rummanwaqar/speedy_bldc/README.md

# Speedy - The Badass Brushless Motor Controller
