rummanwaqar/speedy_bldc/hardware/sch.png

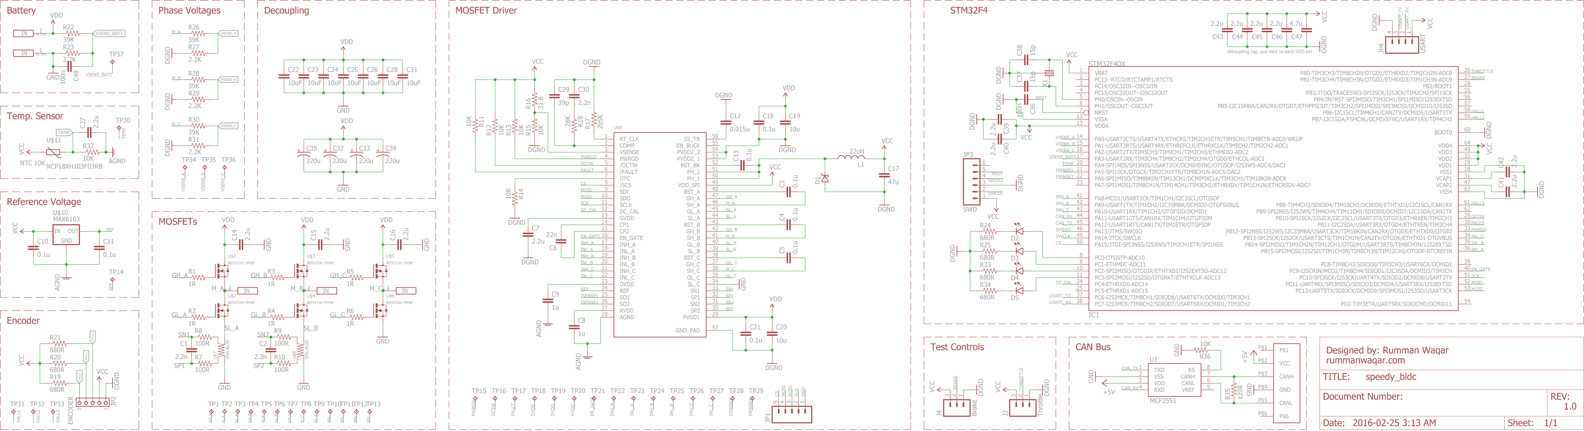
hardware/sch.png
