rummanwaqar/speedy_bldc/hardware/speedy_bldc.sch

## EAGLE design hardware/speedy_bldc.sch (2016-03-04)

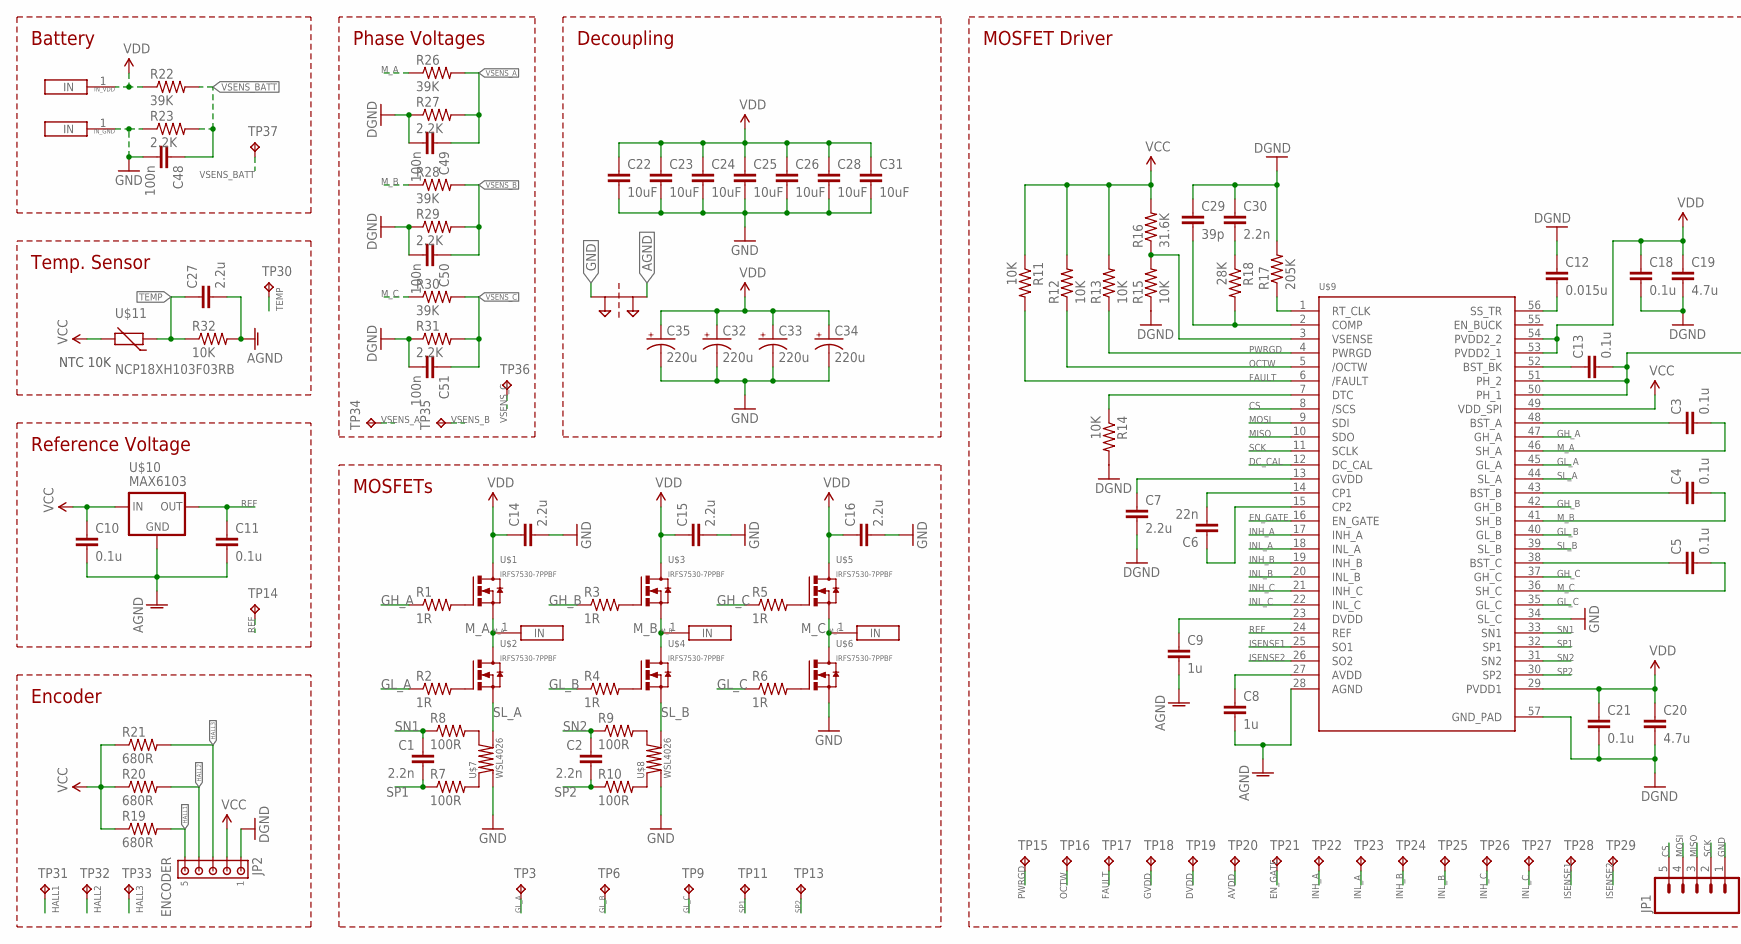
[picture p3: schematic speedy_bldc.sch, part in row 1, column 1]

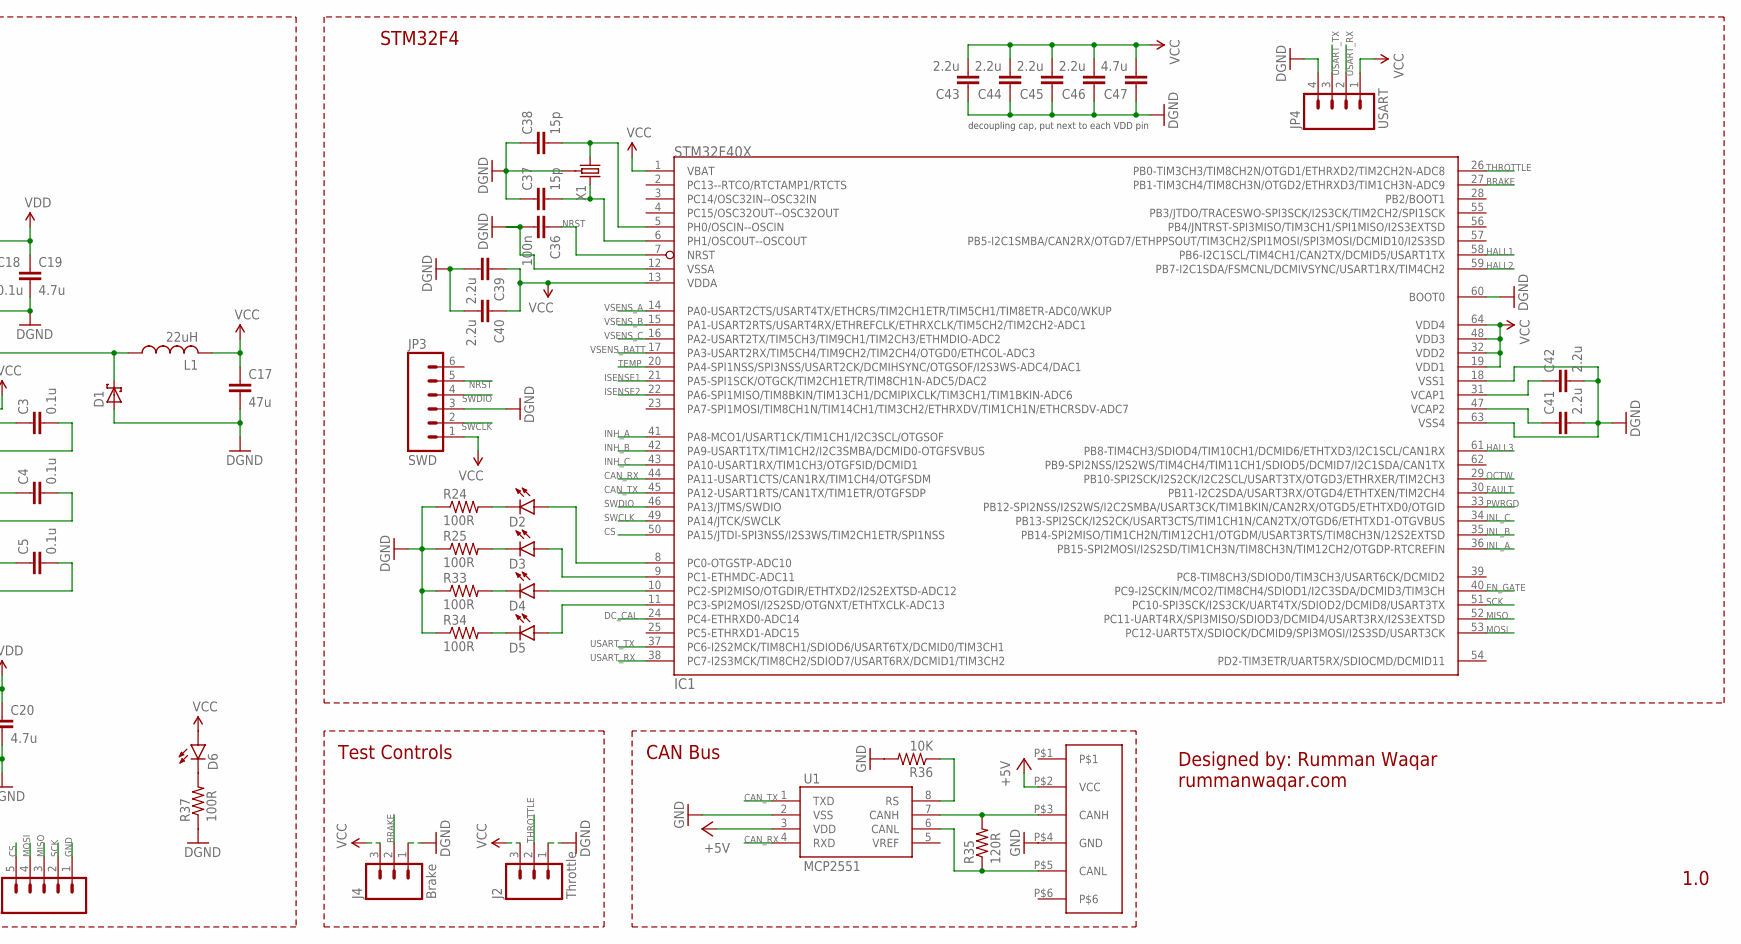
[picture p4: schematic speedy_bldc.sch, part in row 1, column 2]

Parts:
C1, C2, C30: 2.2n; 0603-CAP; PARTNO 399-7880-1-ND
C3, C4, C5: 0.1u; 0603-CAP; VOLTAGE 16V; PARTNO 399-7845-1-ND
C6: 22n; 0603-CAP; VOLTAGE 60V; PARTNO 1276-1936-1-ND
C7: 2.2u; 0603-CAP; VOLTAGE 16V; PARTNO 1276-1879-1-ND
C8: 1u; 0603-CAP; VOLTAGE 10V; PARTNO 587-2984-1-ND
C9: 1u; 0603-CAP; VOLTAGE 6.3V; PARTNO 587-2984-1-ND
C10, C11, C13, C18, C21: 0.1u; 0603-CAP; PARTNO 399-7845-1-ND
C12: 0.015u; 0603-CAP; PARTNO 587-1097-1-ND
C14, C15, C16: 2.2u; 1206-CAP; PARTNO 445-5208-1-ND
C17: 47u; 1206; PARTNO 490-3907-1-ND
C19, C20: 4.7u; 0805; PARTNO 1276-1248-1-ND
C22, C23, C24, C25, C26, C28, C31: 10uF; 1206; PARTNO 587-3248-1-ND
C27, C39, C40, C41, C42, C43, C44, C45, C46: 2.2u; 0603-CAP; PARTNO 1276-1879-1-ND
C29: 39p; 0603-CAP; PARTNO 712-1345-1-ND
C32, C33, C34, C35: 220u; E3,5-8; PARTNO 493-11950-1-ND
C36, C48, C49, C50, C51: 100n; 0603-CAP; PARTNO 399-1097-1-ND
C37, C38: 15p; 0603-CAP; PARTNO 712-1318-1-ND
C47: 4.7u; 0603-CAP; PARTNO 490-3302-1-ND
D1: SCHOTTKY_SMA; SMA; PARTNO 497-12285-1-ND
D2, D3, D4, D5, D6: LED-FKIT-1206; FKIT-LED-1206; PARTNO 160-1457-1-ND
IC1: STM32F40X; LQFP64; PARTNO 497-11767-ND
IN_GND: 1CONN
IN_VDD: 1CONN
J2: Throttle; 1X03
J4: Brake; 1X03
JP1: M05NO_SILK; 1X05_NO_SILK
JP2: ENCODER; 1445055-5; PARTNO A33210-ND
JP3: SWD; 1X06_NO_SILK
JP4: USART; 1X04
L1: 22uH; L5650M; PARTNO 490-5272-1-ND
M_A: 1CONN
M_B: 1CONN
M_C: 1CONN
PT1: 2PT_GND_TIE
R1, R2, R3, R4, R5, R6: 1R; 0603-RES; PARTNO 1276-4991-1-ND
R7, R8, R9, R10, R24, R25, R33, R34, R37: 100R; 0603-RES; PARTNO 311-100HRCT-ND
R11, R12, R13, R14, R15, R36: 10K; 0603-RES; PARTNO 311-10KGRCT-ND
R16: 31.6K; 0603-RES; PARTNO 311-31.6KHRCT-ND
R17: 205K; 0603-RES; PARTNO 541-205KHCT-ND
R18: 28K; 0603-RES; PARTNO 311-28.0KHRCT-ND
R19, R20, R21: 680R; 0603-RES; PARTNO 311-680HRCT-ND
R22, R26, R28, R30: 39K; 0603-RES; PARTNO 311-39.0KHRCT-ND
R23, R27, R29, R31: 2.2K; 0603-RES; PARTNO 311-2.20KHRCT-ND
R32: 10K; 0603-RES; PARTNO RHM10.0KHCT-ND
R35: 120R; 0603-RES; PARTNO 311-120GRCT-ND
TP3, TP6, TP9, TP11, TP13, TP14, TP15, TP16, TP17, TP18, TP19, TP20, TP21, TP22, TP23, TP24, TP25, TP26, TP27, TP28, TP29, TP30, TP31, TP32, TP33, TP34, TP35, TP36, TP37: TPB1,27; B1,27
U1: MCP2551; SO08; PARTNO MCP2551T-E/SNCT-ND
U$1, U$2, U$3, U$4, U$5, U$6: IRFS7530-7PPBF; D2PAK-7PIN; PARTNO IRFS7530-7PPBF-ND
U$7, U$8: WSL4026; PARTNO WSLR-.0003CT-ND
U$9: DRV8301; 56-TSSOP-POWERPAD; PARTNO 296-29433-1-ND
U$10: MAX6103; SOT23-3; PARTNO MAX6103EUR+TCT-ND
U$11: NCP18XH103F03RB; R0603; PARTNO 490-4800-1-ND
U$12: CAN_6P6C; PARTNO 553-2258-ND
X1: X1; CRYSTAL-SMD-5X3; PARTNO 535-9721-1-ND

Connections:
+5V: U1.3 (VDD), U$12.P$2 (VCC)
AGND: C8.2, C9.2, C10.2, C11.2, C27.2, PT1.P$2, R32.2, U$9.28 (AGND), U$10.3 (GND)
AVDD: TP20.TP
BRAKE: IC1.27 (PB1-TIM3CH4/TIM8CH3N/OTGD2/ETHRXD3/TIM1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), J4.2
CAN_RX: IC1.44 (PA11-USART1CTS/CAN1RX/TIM1CH4/OTGFSDM), U1.4 (RXD)
CAN_TX: IC1.45 (PA12-USART1RTS/CAN1TX/TIM1ETR/OTGFSDP), U1.1 (TXD)
CS: IC1.50 (PA15/JTDI-SPI3NSS/I2S3WS/TIM2CH1ETR/SPI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), JP1.5, U$9.8 (/SCS)
DC_CAL: IC1.24 (PC4-ETHRXD0-ADC14), U$9.12 (DC_CAL)
DVDD: TP19.TP
EN_GATE: IC1.40 (PC9-I2SCKIN/MCO2/TIM8CH4/SDIOD1/I2C3SDA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), TP21.TP, U$9.16 (EN_GATE)
FAULT: IC1.30 (PB11-I2C2SDA/USART3RX/OTGD4/ETHTXEN/TIM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), R11.2, TP17.TP, U$9.6 (/FAULT)
GH_A: R1.1, U$9.47 (GH_A)
GH_B: R3.1, U$9.42 (GH_B)
GH_C: R5.1, U$9.37 (GH_C)
GL_A: R2.1, TP3.TP, U$9.45 (GL_A)
GL_B: R4.1, TP6.TP, U$9.40 (GL_B)
GL_C: R6.1, TP9.TP, U$9.35 (GL_C)
GND: C7.2, C12.1, C14.2, C15.2, C16.2, C17.2, C18.2, C19.2, C20.2, C21.2, C22.2, C23.2, C24.2, C25.2, C26.2, C28.2, C29.1, C30.1, C31.2, C32.-, C33.-, C34.-, C35.-, C36.2, C37.1, C38.1, C39.2, C40.2, C41.2, C42.2, C43.1, C44.1, C45.1, C46.1, C47.1, C48.2, C49.2, C50.2, C51.2, D1.A, IC1.12 (VSSA), IC1.18 (VSS1), IC1.60 (BOOT0), IC1.63 (VSS4), IN_GND.1, J2.1, J4.1, JP1.1, JP2.1, JP3.3, JP4.4, PT1.P$1, R14.2, R15.1, R17.2, R23.1, R24.1, R25.1, R27.1, R29.1, R31.1, R33.1, R34.1, R36.2, R37.1, U1.2 (VSS), U$6.S, U$7.P$2, U$8.P$2, U$9.34 (SL_C), U$9.57 (GND_PAD), U$12.P$4 (GND), X1.2 (3)
GVDD: TP18.TP
HALL1: IC1.58 (PB6-I2C1SCL/TIM4CH1/CAN2TX/DCMID5/USART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), JP2.5, R19.2, TP31.TP
HALL2: IC1.59 (PB7-I2C1SDA/FSMCNL/DCMIVSYNC/USART1RX/T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), JP2.4, R20.2, TP32.TP
HALL3: IC1.61 (PB8-TIM4CH3/SDIOD4/TIM10CH1/DCMID6/ETHT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), JP2.3, R21.2, TP33.TP
INH_A: IC1.41 (PA8-MCO1/USART1CK/TIM1CH1/I2C3SCL/OTGSOF), TP22.TP, U$9.17 (INH_A)
INH_B: IC1.42 (PA9-USART1TX/TIM1CH2/I2C3SMBA/DCMID0-OT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), TP24.TP, U$9.19 (INH_B)
INH_C: IC1.43 (PA10-USART1RX/TIM1CH3/OTGFSID/DCMID1), TP26.TP, U$9.21 (INH_C)
INL_A: IC1.36 (PB15-SPI2MOSI/I2S2SD/TIM1CH3N/TIM8CH3N/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), TP23.TP, U$9.18 (INL_A)
INL_B: IC1.35 (PB14-SPI2MISO/TIM1CH2N/TIM12CH1/OTGDM/U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), TP25.TP, U$9.20 (INL_B)
INL_C: IC1.34 (PB13-SPI2SCK/I2S2CK/USART3CTS/TIM1CH1N/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), TP27.TP, U$9.22 (INL_C)
ISENSE1: IC1.21 (PA5-SPI1SCK/OTGCK/TIM2CH1ETR/TIM8CH1N-A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), TP28.TP, U$9.25 (SO1)
ISENSE2: IC1.22 (PA6-SPI1MISO/TIM8BKIN/TIM13CH1/DCMIPIXC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), TP29.TP, U$9.26 (SO2)
MISO: IC1.52 (PC11-UART4RX/SPI3MISO/SDIOD3/DCMID4/USA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), JP1.3, U$9.10 (SDO)
MOSI: IC1.53 (PC12-UART5TX/SDIOCK/DCMID9/SPI3MOSI/I2S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), JP1.4, U$9.9 (SDI)
M_A: C3.2, M_A.1, R26.1, U$1.S, U$2.D, U$9.46 (SH_A)
M_B: C4.2, M_B.1, R28.1, U$3.S, U$4.D, U$9.41 (SH_B)
M_C: C5.2, M_C.1, R30.1, U$5.S, U$6.D, U$9.36 (SH_C)
unnamed: R1.2, U$1.G
unnamed: R2.2, U$2.G
unnamed: R3.2, U$3.G
unnamed: R4.2, U$4.G
unnamed: R6.2, U$6.G
unnamed: R5.2, U$5.G
unnamed: R8.2, U$7.P$3
unnamed: R7.2, U$7.P$4
unnamed: R10.2, U$8.P$4
unnamed: R9.2, U$8.P$3
unnamed: C6.2, U$9.14 (CP1)
unnamed: C6.1, U$9.15 (CP2)
unnamed: C8.1, U$9.27 (AVDD)
unnamed: R15.2, R16.1, U$9.3 (VSENSE)
unnamed: C7.1, U$9.13 (GVDD)
unnamed: C9.1, U$9.23 (DVDD)
unnamed: R17.1, U$9.1 (RT_CLK)
unnamed: C12.2, U$9.56 (SS_TR)
unnamed: C13.2, D1.C, L1.1, U$9.50 (PH_1), U$9.51 (PH_2)
unnamed: C13.1, U$9.52 (BST_BK)
unnamed: R14.1, U$9.7 (DTC)
unnamed: C38.2, IC1.5 (PH0/OSCIN--OSCIN), X1.3 (1)
unnamed: C29.2, R18.2, U$9.2 (COMP)
unnamed: C37.2, IC1.6 (PH1/OSCOUT--OSCOUT), X1.1 (2)
unnamed: D2.C, R24.2
unnamed: C30.2, R18.1
unnamed: D2.A, IC1.8 (PC0-OTGSTP-ADC10)
unnamed: D3.C, R25.2
unnamed: D4.C, R33.2
unnamed: D5.C, R34.2
unnamed: R35.1, U1.6 (CANL), U$12.P$5 (CANL)
unnamed: R35.2, U1.7 (CANH), U$12.P$3 (CANH)
unnamed: R36.1, U1.8 (RS)
unnamed: D6.C, R37.2
unnamed: D3.A, IC1.9 (PC1-ETHMDC-ADC11)
unnamed: C3.1, U$9.48 (BST_A)
unnamed: D4.A, IC1.10 (PC2-SPI2MISO/OTGDIR/ETHTXD2/I2S2EXTSD-A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)
unnamed: C4.1, U$9.43 (BST_B)
unnamed: D5.A, IC1.11 (PC3-SPI2MOSI/I2S2SD/OTGNXT/ETHTXCLK-ADC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)
unnamed: C5.1, U$9.38 (BST_C)
NRST: C36.1, IC1.7 (NRST), JP3.5
OCTW: IC1.29 (PB10-SPI2SCK/I2S2CK/I2C2SCL/USART3TX/OT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), R12.1, TP16.TP, U$9.5 (/OCTW)
PWRGD: IC1.33 (PB12-SPI2NSS/I2S2WS/I2C2SMBA/USART3CK/T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), R13.1, TP15.TP, U$9.4 (PWRGD)
REF: C11.1, TP14.TP, U$9.24 (REF), U$10.2 (OUT)
SCK: IC1.51 (PC10-SPI3SCK/I2S3CK/UART4TX/SDIOD2/DCMI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), JP1.2, U$9.11 (SCLK)
SL_A: U$2.S, U$7.P$1, U$9.44 (SL_A)
SL_B: U$4.S, U$8.P$1, U$9.39 (SL_B)
SN1: C1.1, R8.1, U$9.33 (SN1)
SN2: C2.1, R9.1, U$9.31 (SN2)
SP1: C1.2, R7.1, TP11.TP, U$9.32 (SP1)
SP2: C2.2, R10.1, TP13.TP, U$9.30 (SP2)
SWCLK: IC1.49 (PA14/JTCK/SWCLK), JP3.2
SWDIO: IC1.46 (PA13/JTMS/SWDIO), JP3.4
TEMP: C27.1, IC1.20 (PA4-SPI1NSS/SPI3NSS/USART2CK/DCMIHSYNC/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), R32.1, TP30.TP, U$11.1
THROTTLE: IC1.26 (PB0-TIM3CH3/TIM8CH2N/OTGD1/ETHRXD2/TIM2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), J2.2
USART_RX: IC1.38 (PC7-I2S3MCK/TIM8CH2/SDIOD7/USART6RX/DCM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), JP4.2
USART_TX: IC1.37 (PC6-I2S2MCK/TIM8CH1/SDIOD6/USART6TX/DCM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), JP4.3
VCAP1: C42.1, IC1.31 (VCAP1)
VCAP2: C41.1, IC1.47 (VCAP2)
VCC: C10.1, C17.1, C39.1, C40.1, C43.2, C44.2, C45.2, C46.2, C47.2, D6.A, IC1.1 (VBAT), IC1.13 (VDDA), IC1.19 (VDD1), IC1.32 (VDD2), IC1.48 (VDD3), IC1.64 (VDD4), J2.3, J4.3, JP2.2, JP3.1, JP4.1, L1.2, R11.1, R12.2, R13.2, R16.2, R19.1, R20.1, R21.1, U$9.49 (VDD_SPI), U$10.1 (IN), U$11.2
VDD: C14.1, C15.1, C16.1, C18.1, C19.1, C20.1, C21.1, C22.1, C23.1, C24.1, C25.1, C26.1, C28.1, C31.1, C32.+, C33.+, C34.+, C35.+, IN_VDD.1, R22.1, U$1.D, U$3.D, U$5.D, U$9.29 (PVDD1), U$9.53 (PVDD2_1), U$9.54 (PVDD2_2)
VSENS_A: C49.1, IC1.14 (PA0-USART2CTS/USART4TX/ETHCRS/TIM2CH1ET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), R26.2, R27.2, TP34.TP
VSENS_B: C50.1, IC1.15 (PA1-USART2RTS/USART4RX/ETHREFCLK/ETHRXC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), R28.2, R29.2, TP35.TP
VSENS_BATT: C48.1, IC1.17 (PA3-USART2RX/TIM5CH4/TIM9CH2/TIM2CH4/OT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), R22.2, R23.2, TP37.TP
VSENS_C: C51.1, IC1.16 (PA2-USART2TX/TIM5CH3/TIM9CH1/TIM2CH3/ET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), R30.2, R31.2, TP36.TP

Notes on the sheet:
MOSFETs
Reference Voltage
MOSFET Driver
NTC 10K
Temp. Sensor
Encoder
Test Controls
Phase Voltages
Battery
Decoupling
decoupling cap, put next to each VDD pin
STM32F4
CAN Bus
1.0
Designed by: Rumman Waqar rummanwaqar.com
