rummanwaqar/speedy_bldc/(commit log)

2016-02-25 Added schematic
    [speedy_bldc.sch]
2016-02-25 Moved hardware into its own folder
    [speedy_bldc.sch]
2016-03-04 Added BOM
    [BOM.csv, speedy_bldc.sch]
